sharkie-0000/rc-car/bom.csv

Component | Quantity | Purchase Link | Price
ESP32 Dev Board | 1 | https://robu.in/product/esp-wroom-32-wifi-bluetooth-networking-smart-component-development-board/ | $3.96
TB6612FNG Motor Driver | 1 | https://robu.in/product/motor-driver-tb6612fng-module-performance-ultra-small-volume-3-pi-matching-performance-ultra-l298n/ | $1.45
TT Dual Shaft DC Motor | 2 | https://robu.in/product/230rpm-straight-type-dual-side-6v-bo-motor/ | $1.27/pc
65mm Wheels | 2 | https://robu.in/product/robot-smart-car-wheel-tyre-bo-motor/ | $0.25/pc
18650 Li-ion Battery | 2 | https://robocraze.com/products/18650-2200mah-3-7v-battery-cylinder-type-blue | $1.45/pc
18650 Battery Holder | 1 | https://robu.in/product/black-plastic-storage-box-case-holder-battery-3-x-18650-cell-box-without-cover/ | $0.26
LM2596S Buck Converter | 1 | https://robu.in/product/lm2596s-dc-dc-buck-converter-power-supply/ | $0.44
Screws/Nuts/Spacers | As required | Local Hardware Store | $4-$5
3D Printed Parts | 12 | Self Printed | I got a printer
