sharkie-0000/rc-car/cad/soccer (Assembly).step

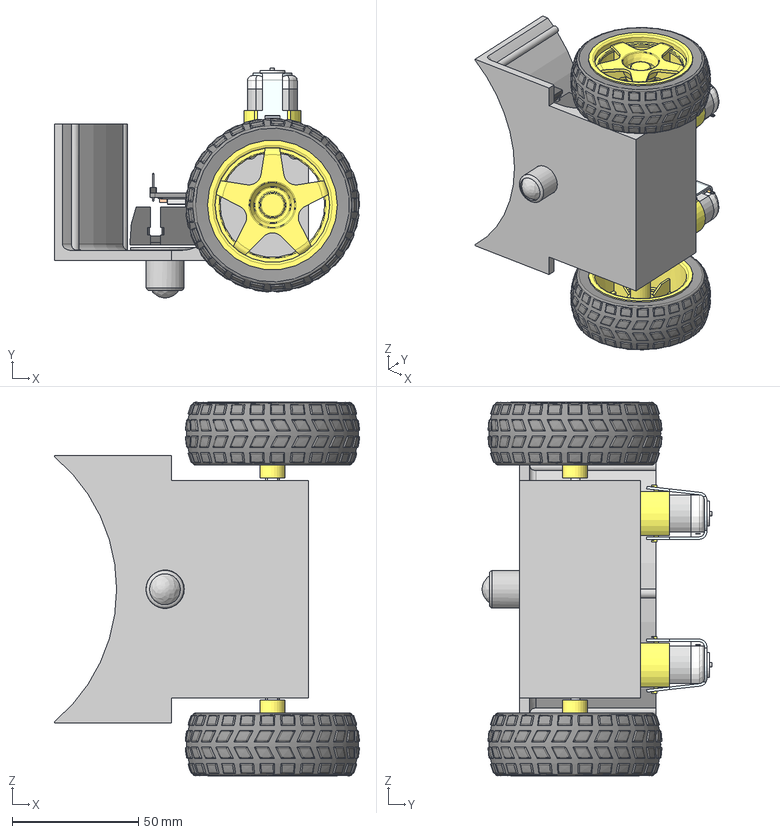
[picture p4: CAD file, 2026-10-31]
cad/soccer (Assembly).step
120.7 x 91.0 x 148.0 mm
