sharkie-0000/rc-car/cad/main_base.stl

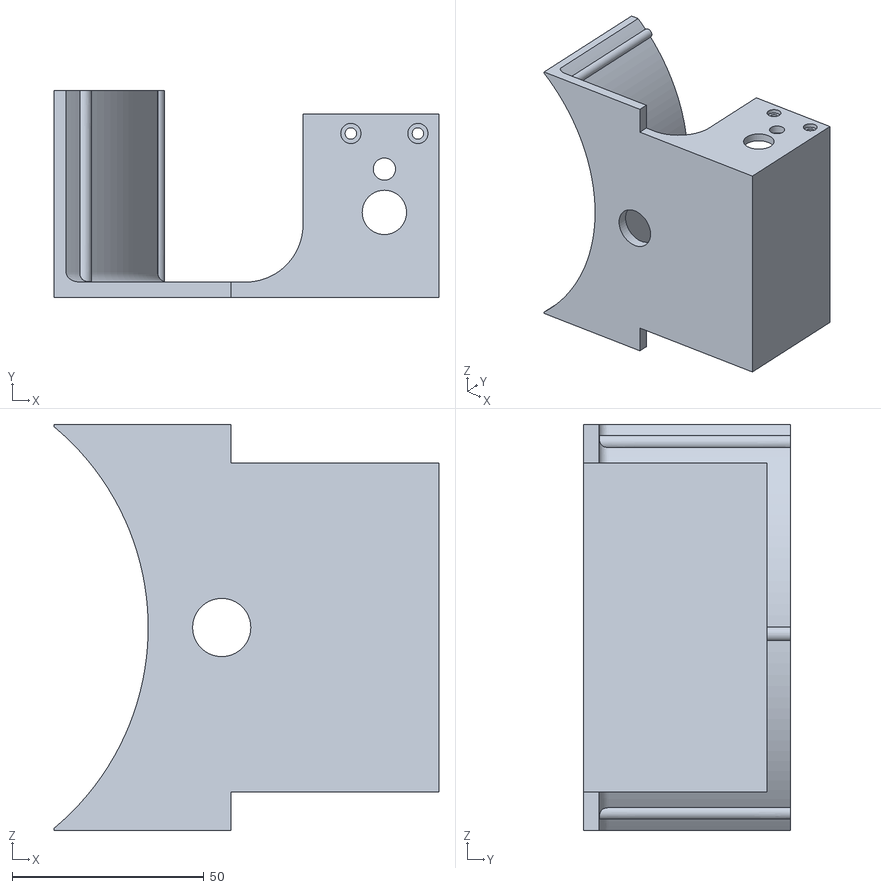
[picture p5: CAD file, 2026-10-31]
cad/main_base.stl
100.5 x 54.0 x 106.0
