sharkie-0000/rc-car/cad/motor_bridge.stl

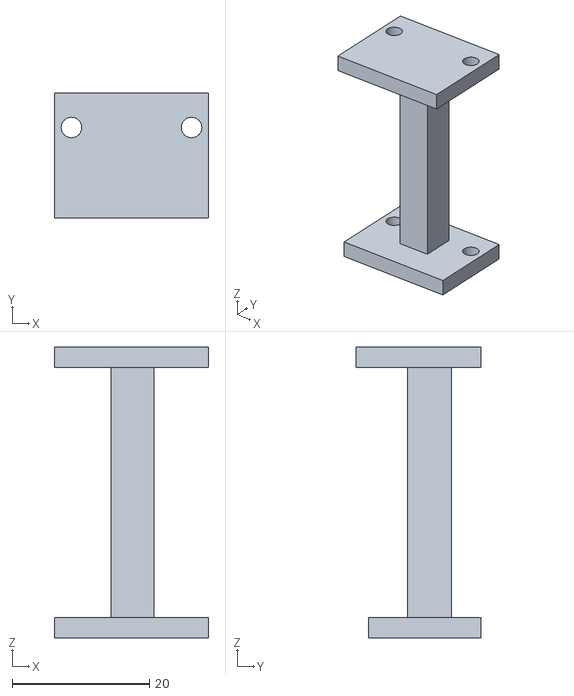
[picture p6: CAD file, 2026-10-31]
cad/motor_bridge.stl
22.5 x 18.3 x 42.4
