sharkie-0000/rc-car/(list of files, cad)

Other CAD files:
cad/soccer (Assembly).f3z
